fuhrahmann/Automatic-Cane-Feeding-Control/src/MATLAB/SystemIdentificationData.xlsx

Sheet: CaneCarrierCalculation
KALKULASI CONVEYOR
 |  |  |  |  |  | n1 =
Name | Operator/Id | Bilangan | Satuan | Kondisi Real |  | 1490
RPM Nameplate Elmot | = | 1490 | (rpm) | 1490 |  | rpm
Hz Inverter | = | 50 |  | 25
Putaran Elmot |  | 1490.0 | (rpm) | 745.0
Ratio Gearbox | : | 42.87 | ratio | 40
Putaran Output Gearbox | = | 34.76 | (rpm) | 18.62 |  |  |  |  | n2 =
Ratio Transmisi Rantai Gigi Sprocket | Z1 | 25 | gigi | 1 |  |  |  |  | 54.31
 | Z2 | 16 | gigi | 1 |  |  |  |  | rpm
RPM Akhir | = | 54.31 | (rpm) | 18.62 |  |  |  |  |  | z2=
 |  |  |  |  |  |  | z1= | 25 |  | 16
DIMENSI CONVEYOR |  |  |  | Kondisi Real
Volume Kapasitas Konveyor | panjang as ke as | 1.2 | (m) | 13.20
 | lebar | 0.02 | (m) | 1.51
 | tinggi holder | 0.07 | (m)
 | = | 0.00156 | (m3)
Diameter Sprocket Konveyor | = | 70 | (mm) | 1000 |  |  |  | 54.31
 | = | 0.07 | (mtr) | 1
Keliling Sprocket Konveyor | = | 0.22 | (mtr) | 3.14
Diameter Sprocket Penggerak Conveyor | = | 0.07 | (mtr) |  |  |  |  |  |  | Kec. conveyor = | 11.95 | mtr/menit
Keliling Sprocket Penggerak Konveyor | = | 0.22 | (mtr)
KECEPATAN CONVEYOR | = | 11.947 | (mtr/menit) | 58.54 | (mtr/menit)
 |  | 0.1991 | (mtr/detik) | 0.976 | (mtr/detik)
KAPASITAS KONVEYOR
Beban Material | tebu | 150.00 | kg/m3
Kapasitas tebu antar | = | 234 | g
 | = | 2795.71 | g/menit
 | = | 167.74 | g/jam
PERHITUNGAN TORSI MOTOR
Total Massa Bergerak | = | 19.71 | kg
Gaya | = | 167.28 | N
Gaya gesek | = | 25.09 | N
Total Gaya | = | 192.37 | N
Torsi Beban | = | 6.73 | Nm
Kapasitas motor | = | 1 | HP
 | = | 745.7 | Watt
Torsi Motor | = | 5.126 | Nm
Torsi Akhir (+ Gearbox) | = | 219.733 | Nm

Sheet: Data_PSU12V-BuckConverter
VIN PSU | Pengujian 1 |  | Pengujian 2 |  | Pengujian 3 |  | Rata-rata
 | VOUT | Selisih | VOUT | Selisih | VOUT | Selisih | Vout | Selisih
10.23 | 9.17 | 0 | 9.17 | 0 | 9.17 | 0 | 9.17 | 0
11.20 | 9.19 | 0.02 | 9.18 | 0.01 | 9.17 | 0.00 | 9.18 | 0.01
12.18 | 9.18 | -0.01 | 9.17 | -0.01 | 9.19 | 0.02 | 9.18 | 0.00
13.12 | 9.20 | 0.02 | 9.21 | 0.04 | 9.20 | 0.01 | 9.20 | 0.02
14.13 | 9.20 | 0.00 | 9.20 | -0.01 | 9.20 | 0.00 | 9.20 | -0.003333333333
15.02 | 9.20 | 0.00 | 9.20 | 0.00 | 9.20 | 0.00 | 9.19 | 0.01

Sheet: KapasitasBeban
Beban (gram) | Frekuensi | Pengujian Penumpukan (s) |  |  | Rata-rata | Kapasitas (g/s)
 |  | 1 | 2 | 3
250 | 10 | 420 | 405 | 415 | 413.33 | 0.605
 | 20 | 195 | 189 | 202 | 195.33 | 1.280
 | 30 | 125 | 135 | 140 | 133.33 | 1.875
 | 40 | 90 | 85 | 95 | 90.00 | 2.778
 | 50 | 72 | 78 | 75 | 75.00 | 3.333
500 | 10 | 210 | 198 | 205 | 204.33 | 2.447
 | 20 | 95 | 89 | 95 | 93.00 | 5.376
 | 30 | 62 | 68 | 67 | 65.67 | 7.614
 | 40 | 45 | 43 | 45 | 44.33 | 11.278
 | 50 | 36 | 39 | 38 | 37.67 | 13.274
750 | 10 | 140 | 135 | 145 | 140.00 | 5.357
 | 20 | 65 | 70 | 63 | 66.00 | 11.364
 | 30 | 42 | 45 | 48 | 45.00 | 16.667
 | 40 | 32 | 30 | 34 | 32.00 | 23.438
 | 50 | 25 | 28 | 27 | 26.67 | 28.125
1000 | 10 | 105 | 98 | 100 | 101.00 | 9.901
 | 20 | 47 | 41 | 54 | 47.33 | 21.127
 | 30 | 30 | 35 | 37 | 34.00 | 29.412
 | 40 | 22 | 21 | 22 | 21.67 | 46.154
 | 50 | 17 | 20 | 19 | 18.67 | 53.571
1500 | 10 | 68 | 72 | 65 | 68.33 | 21.951
 | 20 | 32 | 36 | 30 | 32.67 | 45.918
 | 30 | 21 | 19 | 23 | 21.00 | 71.429
 | 40 | 15 | 16 | 17 | 16.00 | 93.75
 | 50 | 12 | 11 | 14 | 12.33 | 121.62

Sheet: Data_PWM-VFDATV12
PWM | Pengujian 1 |  | Pengujian 2 |  | Pengujian 3 |  | Rata-rata
 | VDC IN | Hz | VDC IN | Hz | VDC IN | Hz | Mean VDC | Mean Hz
1 | 0.04 | 0.40 | 0.05 | 0.40 | 0.04 | 0.40 | 0.04 | 0.40
3 | 0.09 | 0.90 | 0.08 | 0.90 | 0.09 | 0.90 | 0.09 | 0.90
5 | 0.12 | 1.30 | 0.13 | 1.40 | 0.12 | 1.30 | 0.12 | 1.33
7 | 0.16 | 1.70 | 0.17 | 1.80 | 0.16 | 1.80 | 0.16 | 1.77
9 | 0.20 | 2.10 | 0.20 | 2.20 | 0.20 | 2.10 | 0.20 | 2.13
11 | 0.24 | 2.60 | 0.24 | 2.50 | 0.24 | 2.70 | 0.24 | 2.60
13 | 0.28 | 2.90 | 0.29 | 3.00 | 0.29 | 3.10 | 0.29 | 3.00
15 | 0.32 | 3.30 | 0.33 | 3.50 | 0.33 | 3.60 | 0.33 | 3.47
17 | 0.36 | 3.70 | 0.36 | 3.90 | 0.36 | 4.00 | 0.36 | 3.87
19 | 0.40 | 4.17 | 0.41 | 4.31 | 0.41 | 4.47 | 0.40 | 4.32
21 | 0.44 | 4.58 | 0.45 | 4.74 | 0.45 | 4.92 | 0.44 | 4.75
23 | 0.48 | 4.99 | 0.49 | 5.17 | 0.49 | 5.37 | 0.48 | 5.18
25 | 0.52 | 5.40 | 0.53 | 5.60 | 0.53 | 5.82 | 0.52 | 5.61
27 | 0.56 | 5.81 | 0.57 | 6.02 | 0.57 | 6.27 | 0.56 | 6.04
29 | 0.59 | 6.22 | 0.61 | 6.45 | 0.61 | 6.72 | 0.61 | 6.47
31 | 0.63 | 6.64 | 0.65 | 6.88 | 0.65 | 7.18 | 0.65 | 6.90
33 | 0.67 | 7.05 | 0.69 | 7.30 | 0.69 | 7.63 | 0.69 | 7.33
35 | 0.71 | 7.46 | 0.73 | 7.73 | 0.73 | 8.08 | 0.73 | 7.76
37 | 0.75 | 7.87 | 0.77 | 8.16 | 0.78 | 8.53 | 0.77 | 8.19
39 | 0.79 | 8.28 | 0.81 | 8.59 | 0.82 | 8.98 | 0.81 | 8.62
41 | 0.83 | 8.70 | 0.85 | 9.01 | 0.86 | 9.43 | 0.85 | 9.05
43 | 0.87 | 9.11 | 0.89 | 9.44 | 0.90 | 9.88 | 0.89 | 9.48
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
249 | 4.97 | 50.00 | 4.96 | 50.00 | 4.97 | 50.00 | 4.97 | 50.00
251 | 5.01 | 50.00 | 5.01 | 50.00 | 5.00 | 50.00 | 5.01 | 50.00
253 | 5.05 | 50.00 | 5.05 | 50.00 | 5.05 | 50.00 | 5.05 | 50.00
255 | 5.09 | 50.00 | 5.09 | 50.00 | 5.09 | 50.00 | 5.09 | 50.00

Sheet: DataMotorVFDTanpaBeban
Frekuensi VFD (Hz) | Pengujian 1 | Pengujian 2 | Pengujian 3 | Rata-rata
 | RPM | RPM | RPM | RPM
10 | 11.5 | 11.8 | 11.5 | 11.6
20 | 22.2 | 22.3 | 22.1 | 22.2
30 | 33.1 | 33 | 33.1 | 33.07
40 | 44.1 | 44 | 43.9 | 44
50 | 54.9 | 54.7 | 54.8 | 54.8

Sheet: DataMotorVFDDenganBeban
Frekuensi VFD (Hz) | Pengujian 1 | Pengujian 2 | Pengujian 3 | Rata-rata
 | RPM | RPM | RPM | RPM
10 | 10.4 | 11.1 | 11.8 | 11.1
20 | 21.9 | 22.3 | 22.2 | 22.13
30 | 33 | 32.7 | 32.2 | 32.63
40 | 43.2 | 42.7 | 43.5 | 43.13
50 | 52.9 | 53.5 | 53.7 | 53.37

Sheet: SystemIdentificationData
PWM | Level | S1 | S2 | S3 | S4 | S5 | RPM
1 | 0 | 1 | 1 | 1 | 1 | 1 | 0.21
1 | 0 | 1 | 1 | 1 | 1 | 1 | 0.21
1 | 0 | 1 | 1 | 1 | 1 | 1 | 0.21
1 | 0 | 1 | 1 | 1 | 1 | 1 | 0.21
1 | 0 | 1 | 1 | 1 | 1 | 1 | 0.21
1 | 0 | 1 | 1 | 1 | 1 | 1 | 0.21
1 | 0 | 1 | 1 | 1 | 1 | 1 | 0.21
1 | 0 | 1 | 1 | 1 | 1 | 1 | 0.21
1 | 0 | 1 | 1 | 1 | 1 | 1 | 0.21
1 | 0 | 1 | 1 | 1 | 1 | 1 | 0.21
2 | 0 | 1 | 1 | 1 | 1 | 1 | 0.43
2 | 0 | 1 | 1 | 1 | 1 | 1 | 0.43
2 | 0 | 1 | 1 | 1 | 1 | 1 | 0.43
2 | 0 | 1 | 1 | 1 | 1 | 1 | 0.43
2 | 0 | 1 | 1 | 1 | 1 | 1 | 0.43
2 | 0 | 1 | 1 | 1 | 1 | 1 | 0.43
2 | 0 | 1 | 1 | 1 | 1 | 1 | 0.43
2 | 0 | 1 | 1 | 1 | 1 | 1 | 0.43
2 | 0 | 1 | 1 | 1 | 1 | 1 | 0.43
2 | 0 | 1 | 1 | 1 | 1 | 1 | 0.43
3 | 0 | 1 | 1 | 1 | 1 | 1 | 0.64
3 | 0 | 1 | 1 | 1 | 1 | 1 | 0.64
3 | 0 | 1 | 1 | 1 | 1 | 1 | 0.64
3 | 0 | 1 | 1 | 1 | 1 | 1 | 0.64
3 | 0 | 1 | 1 | 1 | 1 | 1 | 0.64
3 | 0 | 1 | 1 | 1 | 1 | 1 | 0.64
3 | 0 | 1 | 1 | 1 | 1 | 1 | 0.64
3 | 0 | 1 | 1 | 1 | 1 | 1 | 0.64
3 | 0 | 1 | 1 | 1 | 1 | 1 | 0.64
3 | 0 | 1 | 1 | 1 | 1 | 1 | 0.64
4 | 0 | 1 | 1 | 1 | 1 | 1 | 0.85
4 | 0 | 1 | 1 | 1 | 1 | 1 | 0.85
4 | 0 | 1 | 1 | 1 | 1 | 1 | 0.85
4 | 0 | 1 | 1 | 1 | 1 | 1 | 0.85
4 | 0 | 1 | 1 | 1 | 1 | 1 | 0.85
4 | 0 | 1 | 1 | 1 | 1 | 1 | 0.85
4 | 0 | 1 | 1 | 1 | 1 | 1 | 0.85
4 | 0 | 1 | 1 | 1 | 1 | 1 | 0.85
4 | 0 | 1 | 1 | 1 | 1 | 1 | 0.85
4 | 0 | 1 | 1 | 1 | 1 | 1 | 0.85
5 | 0 | 1 | 1 | 1 | 1 | 1 | 1.06
5 | 0 | 1 | 1 | 1 | 1 | 1 | 1.06
5 | 0 | 1 | 1 | 1 | 1 | 1 | 1.06
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
253 | 5 | 1 | 0 | 0 | 0 | 0 | 53.88
253 | 5 | 1 | 0 | 0 | 0 | 0 | 53.88
254 | 5 | 1 | 0 | 0 | 0 | 0 | 54.1
254 | 5 | 1 | 0 | 0 | 0 | 0 | 54.1
254 | 5 | 1 | 0 | 0 | 0 | 0 | 54.1
254 | 5 | 1 | 0 | 0 | 0 | 0 | 54.1
254 | 5 | 1 | 0 | 0 | 0 | 0 | 54.1
254 | 5 | 1 | 0 | 0 | 0 | 0 | 54.1
254 | 5 | 1 | 0 | 0 | 0 | 0 | 54.1
254 | 5 | 1 | 0 | 0 | 0 | 0 | 54.1
254 | 5 | 1 | 0 | 0 | 0 | 0 | 54.1
254 | 5 | 1 | 0 | 0 | 0 | 0 | 54.1
255 | 5 | 1 | 0 | 0 | 0 | 0 | 54.31
255 | 5 | 1 | 0 | 0 | 0 | 0 | 54.31
255 | 5 | 1 | 0 | 0 | 0 | 0 | 54.31
255 | 5 | 1 | 0 | 0 | 0 | 0 | 54.31
255 | 5 | 1 | 0 | 0 | 0 | 0 | 54.31
255 | 5 | 1 | 0 | 0 | 0 | 0 | 54.31
255 | 5 | 1 | 0 | 0 | 0 | 0 | 54.31
255 | 5 | 1 | 0 | 0 | 0 | 0 | 54.31
255 | 5 | 1 | 0 | 0 | 0 | 0 | 54.31
255 | 5 | 1 | 0 | 0 | 0 | 0 | 54.31

Sheet: OpenLoop
No. | PWM | Level | S1 | S2 | S3 | S4 | S5
1 | 1 | 0 | 1 | 1 | 1 | 1 | 1
2 | 2 | 0 | 1 | 1 | 1 | 1 | 1
3 | 3 | 0 | 1 | 1 | 1 | 1 | 1
4 | 4 | 0 | 1 | 1 | 1 | 1 | 1
5 | 5 | 0 | 1 | 1 | 1 | 1 | 1
6 | 6 | 0 | 1 | 1 | 1 | 1 | 1
7 | 7 | 0 | 1 | 1 | 1 | 1 | 1
8 | 8 | 0 | 1 | 1 | 1 | 1 | 1
9 | 9 | 0 | 1 | 1 | 1 | 1 | 1
10 | 10 | 0 | 1 | 1 | 1 | 1 | 1
11 | 11 | 0 | 1 | 1 | 1 | 1 | 1
12 | 12 | 0 | 1 | 1 | 1 | 1 | 1
13 | 13 | 0 | 1 | 1 | 1 | 1 | 1
14 | 14 | 0 | 1 | 1 | 1 | 1 | 1
15 | 15 | 0 | 1 | 1 | 1 | 1 | 1
16 | 16 | 0 | 1 | 1 | 1 | 1 | 1
17 | 17 | 0 | 1 | 1 | 1 | 1 | 1
18 | 18 | 0 | 1 | 1 | 1 | 1 | 1
19 | 19 | 0 | 1 | 1 | 1 | 1 | 1
20 | 20 | 0 | 1 | 1 | 1 | 1 | 1
21 | 21 | 0 | 1 | 1 | 1 | 1 | 1
22 | 22 | 1 | 0 | 1 | 1 | 1 | 1
23 | 23 | 1 | 0 | 1 | 1 | 1 | 1
24 | 24 | 1 | 0 | 1 | 1 | 1 | 1
25 | 25 | 1 | 0 | 1 | 1 | 1 | 1
26 | 26 | 1 | 0 | 1 | 1 | 1 | 1
27 | 27 | 1 | 0 | 1 | 1 | 1 | 1
28 | 28 | 1 | 0 | 1 | 1 | 1 | 1
29 | 29 | 1 | 0 | 1 | 1 | 1 | 1
30 | 30 | 1 | 0 | 1 | 1 | 1 | 1
31 | 31 | 1 | 0 | 1 | 1 | 1 | 1
32 | 32 | 1 | 0 | 1 | 1 | 1 | 1
33 | 33 | 1 | 0 | 1 | 1 | 1 | 1
34 | 34 | 1 | 0 | 1 | 1 | 1 | 1
35 | 35 | 1 | 0 | 1 | 1 | 1 | 1
36 | 36 | 1 | 0 | 1 | 1 | 1 | 1
37 | 37 | 1 | 0 | 1 | 1 | 1 | 1
38 | 38 | 1 | 0 | 1 | 1 | 1 | 1
39 | 39 | 1 | 0 | 1 | 1 | 1 | 1
40 | 40 | 1 | 0 | 1 | 1 | 1 | 1
41 | 41 | 1 | 0 | 1 | 1 | 1 | 1
42 | 42 | 1 | 0 | 1 | 1 | 1 | 1
43 | 43 | 1 | 0 | 1 | 1 | 1 | 1
44 | 44 | 1 | 0 | 1 | 1 | 1 | 1
45 | 45 | 1 | 0 | 1 | 1 | 1 | 1
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
248 | 248 | 5 | 1 | 0 | 0 | 0 | 0
249 | 249 | 5 | 1 | 0 | 0 | 0 | 0
250 | 250 | 5 | 1 | 0 | 0 | 0 | 0
251 | 251 | 5 | 1 | 0 | 0 | 0 | 0
252 | 252 | 5 | 1 | 0 | 0 | 0 | 0
253 | 253 | 5 | 1 | 0 | 0 | 0 | 0
254 | 254 | 5 | 1 | 0 | 0 | 0 | 0
255 | 255 | 5 | 1 | 0 | 0 | 0 | 0

Sheet: PIDCaneCarrierDataSample100ms
Error | PIDValue | PWM | CurrentLevel | DutyCycle
4 | 31073.27 | 255 | 0 | 100
4 | 245.14 | 245 | 0 | 96.08
4 | 249.81 | 249 | 0 | 97.65
4 | 254.48 | 254 | 0 | 99.61
4 | 259.16 | 255 | 0 | 100
4 | 263.83 | 255 | 0 | 100
4 | 268.5 | 255 | 0 | 100
4 | 273.17 | 255 | 0 | 100
4 | 277.84 | 255 | 0 | 100
4 | 282.52 | 255 | 0 | 100
4 | 287.19 | 255 | 0 | 100
4 | 291.86 | 255 | 0 | 100
4 | 296.53 | 255 | 0 | 100
4 | 301.2 | 255 | 0 | 100
4 | 305.88 | 255 | 0 | 100
4 | 310.55 | 255 | 0 | 100
4 | 315.22 | 255 | 0 | 100
4 | 319.89 | 255 | 0 | 100
4 | 324.56 | 255 | 0 | 100
4 | 329.24 | 255 | 0 | 100
4 | 333.91 | 255 | 0 | 100
4 | 338.58 | 255 | 0 | 100
4 | 343.25 | 255 | 0 | 100
4 | 347.92 | 255 | 0 | 100
4 | 352.6 | 255 | 0 | 100
4 | 356.8 | 255 | 0 | 100
4 | 356.8 | 255 | 0 | 100
4 | 356.8 | 255 | 0 | 100
4 | 356.8 | 255 | 0 | 100
4 | 356.8 | 255 | 0 | 100
4 | 356.8 | 255 | 0 | 100
4 | 356.8 | 255 | 0 | 100
4 | 356.8 | 255 | 0 | 100
4 | 356.8 | 255 | 0 | 100
4 | 356.8 | 255 | 0 | 100
4 | 356.8 | 255 | 0 | 100
4 | 356.8 | 255 | 0 | 100
4 | 356.8 | 255 | 0 | 100
4 | 356.8 | 255 | 0 | 100
4 | 356.8 | 255 | 0 | 100
4 | 356.8 | 255 | 0 | 100
4 | 356.8 | 255 | 0 | 100
4 | 356.8 | 255 | 0 | 100
4 | 356.8 | 255 | 0 | 100
4 | 356.8 | 255 | 0 | 100
4 | 356.8 | 255 | 0 | 100
4 | 356.8 | 255 | 0 | 100
4 | 356.8 | 255 | 0 | 100
4 | 356.8 | 255 | 0 | 100
4 | 356.8 | 255 | 0 | 100
4 | 356.8 | 255 | 0 | 100
4 | 356.8 | 255 | 0 | 100
4 | 356.8 | 255 | 0 | 100
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
4 | 356.8 | 255 | 0 | 100
4 | 356.8 | 255 | 0 | 100
4 | 356.8 | 255 | 0 | 100
4 | 356.8 | 255 | 0 | 100
4 | 356.8 | 255 | 0 | 100
4 | 356.8 | 255 | 0 | 100
4 | 356.8 | 255 | 0 | 100
4 | 356.8 | 255 | 0 | 100
4 | 356.8 | 255 | 0 | 100
4 | 356.8 | 255 | 0 | 100
4 | 356.8 | 255 | 0 | 100

Sheet: Manifest
Imported Data File
This manifest was generated for the connected device. You can edit the device name and channel data here and the Data In worksheet will be updated.
 | Channels
 |  |  |  |  |  |  | Imported file name
 |  | Id | Name | Description | Unit of Measure | Active | C:\Users\fathu\Documents\Custom Data - 2025-07-26 - Recording 1 BismillahKenekKoyoke1.csv | 1
 |  | CH1 | CH1 |  |  | ü | Data Interval (ms)
 |  | CH2 | CH2 |  |  | ü | 150
 |  | CH3 | CH3 |  |  | ü
 |  | CH4 | CH4 |  |  | ü
 |  | CH5 | CH5 |  |  | ü
 |  | CH6 | CH6 |  |  | ü
 |  | CH7 | CH7 |  |  | ü
 |  | CH8 | CH8 |  |  | ü
 |  | CH9 | CH9 |  |  | ü
 |  | CH10 | CH10 |  |  | ü
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
